pedram-rezaie/elizabeth-scope/hardware/bom/BOM.csv

Name | Description | Designator | Footprint | LibRef | Quantity | Value
Cap | Capacitor | C1, C3, C4, C6, C11, C12, C25, C26, C35, C38, C39, C40, C41, C42, C44, C45, C47, C49 | 0603 | Cap | 18 | 100nF
Cap | Capacitor | C2, C30, C33, C106, C107, C108 | 0603 | Cap | 6 | 10uF
Cap | Capacitor | C5 | 0603 | Cap | 1 | 200pF
Cap | Capacitor | C7 | 0603 | Cap | 1 | 560pF
Cap | Capacitor | C8 | 0603 | Cap | 1 | 3.3pF
Cap | Capacitor | C9 | 0603 | Cap | 1 | 2nF
Cap | Capacitor | C10 | 0603 | Cap | 1 | 750pF
Cap | Capacitor | C13, C43 | 0603 | Cap | 2 | 1uF
100uF | 100 µF, 50 V aluminum electrolytic capacitor, ±20%, SMD, 8 × 10.2 mm, 105°C | C15, C17 | CAP-SMD_BD8.0-L8.3-W8.3-FD | VT1H101M0810 | 2
Cap | Capacitor | C22, CP3, CP6, CP7 | 0805 | Cap | 4 | 100nF
Cap | Capacitor | C23, CP4, CP5, CP10 | 0805 | Cap | 4 | 10uF
Cap | Capacitor | C27, C28, C29, C31 | 0603 | Cap | 4 | 0.1uF
Cap | Capacitor | C32 | 0603 | Cap | 1 | 47pF
Cap | Capacitor | C36, C37 | 0603 | Cap | 2 | 22pF
Cap | Capacitor | C46, C48 | 0603 | Cap | 2 | 2,2uF
YLED0805YG | Dual Schottky diode, 70 V, 70 mA, SOT-23 package. | D1 | SOT-23-3 | BAS7004E6327HTSA1 | 1
GBLC08CI-LF-T7 | Bidirectional TVS/ESD protection diode, 8 V standoff, 13.4 V clamping, 0.6 pF capacitance | D2 | SOD-323_L1.8-W1.3-LS2.5-BI | GBLC08CI-LF-T7 | 1
YLED0805YG | LED GREEN CLEAR SMD | D3, D4 | FP-LTST-C171KGKT-MFG | CMP-22017-000037-1 | 2
nSMD050-33V | Resettable PTC fuse, 0.5 A hold current, 33 V max | F1, F2 | 1206 | nSMD050-33V | 2
A2541WV-2P | 2-pin male pin header, 2.54 mm pitch, single-row, straight through-hole, 3 A, 250 V. | H1 | HDR-TH_P2.54-H-M_A2541WV-2P | A2541WV-2P_C225477 | 1
B2B-XH-A(LF)(SN) | 2-pin JST XH series wire-to-board header, 2.5 mm pitch, straight through-hole, 3 A, 250 V | J1, J2 | B2B-XH-A(LF)(SN) | B2B-XH-A(LF)(SN) | 2
GCT_USB4930-00-A_REVA | Type C USB 2.0 Connector | J3 | GCT_USB4930-00-A_REVA | GCT_USB4930-00-A_REVA | 1
AO3401A | P-channel MOSFET, -30 V, -4 A, low RDS(on) | Q1 | SOT-23-3_L2.9-W1.6-P1.90-LS2.8-BR | AO3401A_C5379091 | 1
AO3400A | N-channel MOSFET, 30 V, 5.7 A, low RDS(on) | Q2 | SOT-23-3_L2.9-W1.3-P1.90-LS2.4-BR | AO3400A_C42419946 | 1
Res1 | Resistor | R1, R2, R3, R8, R46, R101, R102, R103 | 0603 | Res1 | 8 | 1k
Res1 | Resistor | R4 | 0603 | Res1 | 1 | 64.9
Res1 | Resistor | R5 | 0603 | Res1 | 1 | 237
Res1 | Resistor | R6 | 0603 | Res1 | 1 | 82.5
Res1 | Resistor | R7 | 0603 | Res1 | 1 | 178
Res1 | Resistor | R9, R26 | 0805 | Res1 | 2 | 100k
Res1 | Resistor | R10 | 0603 | Res1 | 1 | 100k
Res1 | Resistor | R11, R108 | 0603 | Res1 | 2 | 5.1K
Res1 | Resistor | R12 | 0603 | Res1 | 1 | 47k
Res1 | Resistor | R13 | 0603 | Res1 | 1 | 22k
Res1 | Resistor | R17, R18, R19, R20, R21, R22, R23, R24, R37, R105 | 0603 | Res1 | 10 | 47
Res1 | Resistor | R25 | 0603 | Res1 | 1 | 143
Res1 | Resistor | R27 | 0603 | Res1 | 1 | 100
Res1 | Resistor | R40, R41 | 0603 | Res1 | 2 | 10k
Res1 | Resistor | R45 | 0603 | Res1 | 1 | 22
Res1 | Resistor | R100 | 0603 | Res1 | 1 | 1M
3GHz | 50 O right-angle BNC PCB connector, through-hole, DC–3 GHz, 9.5 mm interface | RF1 | ANT-TH_KH-BNC50-3511 | KH-BNC50-3511 | 1
TS-1187A-B-A-B | SMD tactile pushbutton switch, SPST-NO, 12 V, 50 mA, 5.1 × 5.1 × 1.5 mm. | SW1, SW2 | SKQGABE010 | TS-1187A-B-A-B | 2
OPA356AIDBVT | High-speed CMOS single operational amplifier, 200 MHz GBW, rail-to-rail output | U1, U2, U3, U9 | SOT-23-5 | OPA356AIDBVT | 4
OPA1656IDR | Dual FET-input audio op-amp, 2.9nV/vHz, 53MHz GBW, SOIC-8 | U4 | SOIC-8 | OPA1656IDR | 1
USBLC6-2SC6_C5261088 |  | U5 | SOT-23-6_L2.9-W1.6-P0.95-LS2.8-BR | USBLC6-2SC6_C5261088 | 1
AP2112K-3.3TRG1(MS) | 3.3 V, 600 mA fixed-output LDO regulator with enable | U6, U7 | SOT-23-5_L2.9-W1.6-P0.95-LS2.7-BR | AP2112K-3.3TRG1(MS) | 2
ADG708CRUZ-REEL7 | 8:1 low-voltage analog multiplexer/switch, 4.5 O max RON, 55 MHz bandwidth | U8 | TSSOP-16 | ADG708CRUZ-REEL7 | 1
ADC1173CIMTCX/NOPB | 8-bit, 15 MSPS single-channel ADC, 3 V supply | U10 | TSSOP-24 | ADC1173CIMTCX/NOPB | 1
2541WV-05P | 5-pin single-row male pin header, 2.54 mm pitch, through-hole, straight. | U11 | HDR-TH_5P-P2.54-V-M | 2541WV-05P | 1
STM32F407VGT6 |  | U12 | LQFP-100_L14.0-W14.0-P0.50-LS16.0-BL | STM32F407VGT6 | 1
REF3030AIDBZR | 3.0 V precision voltage reference, ±0.2% accuracy, 25 mA output | U13 | SOT-23-3_L2.9-W1.6-P1.90-LS2.8-BR_2 | REF3030AIDBZR | 1
8MHz |  | X1 | CRYSTAL-SMD_4P-L3.2-W2.5-BL | 0132M4-8000F18DZNGL | 1
