pedram-rezaie/elizabeth-scope/hardware/docs/elizabeth.pdf

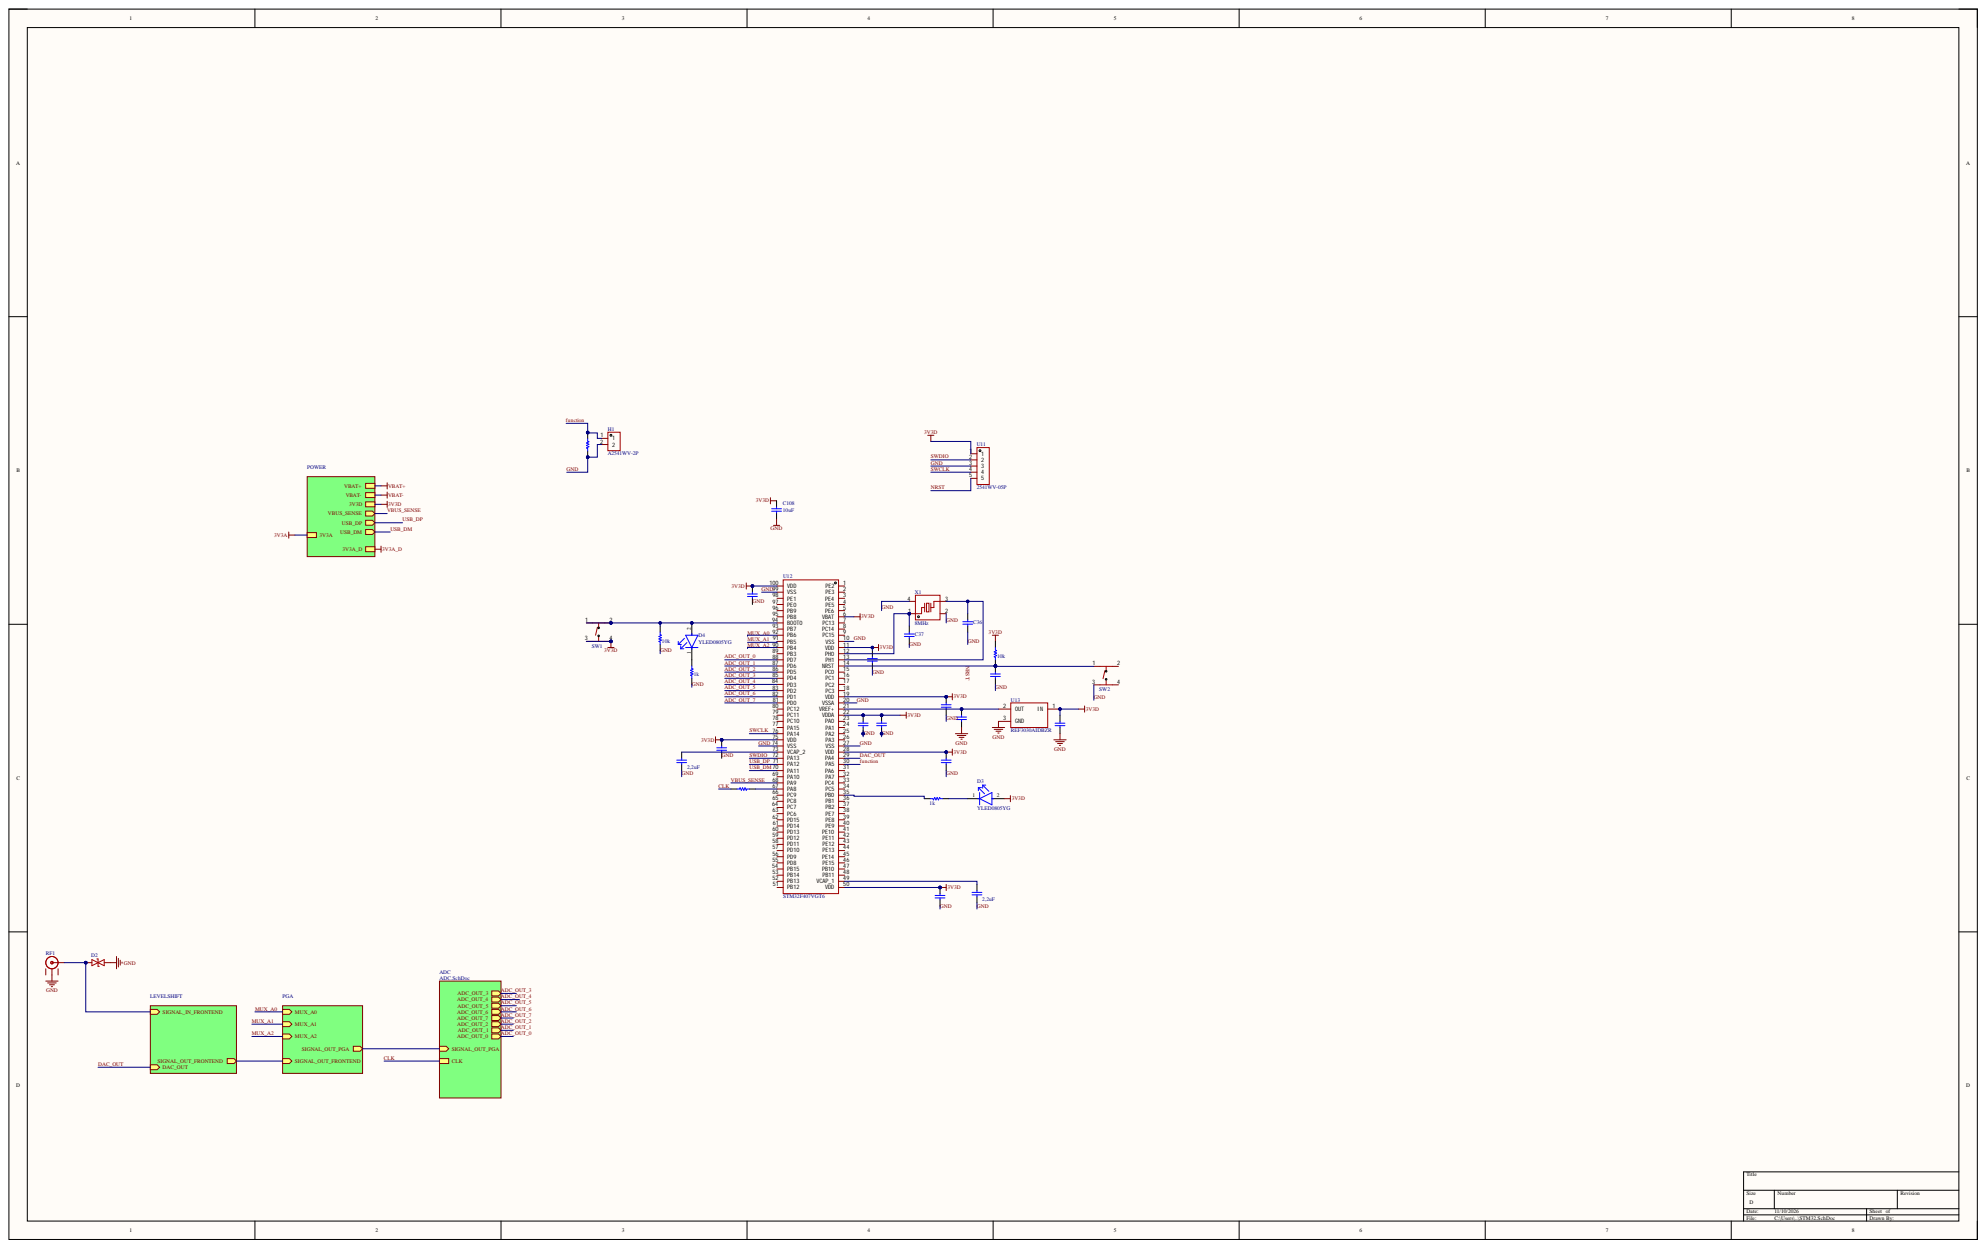
[picture p1: page 1]

Size D | Nu mber | Revision

Date: 11/10/2026 | Sheet of
File: C:\Users\. .\STM32.SchDoc | Drawn By:

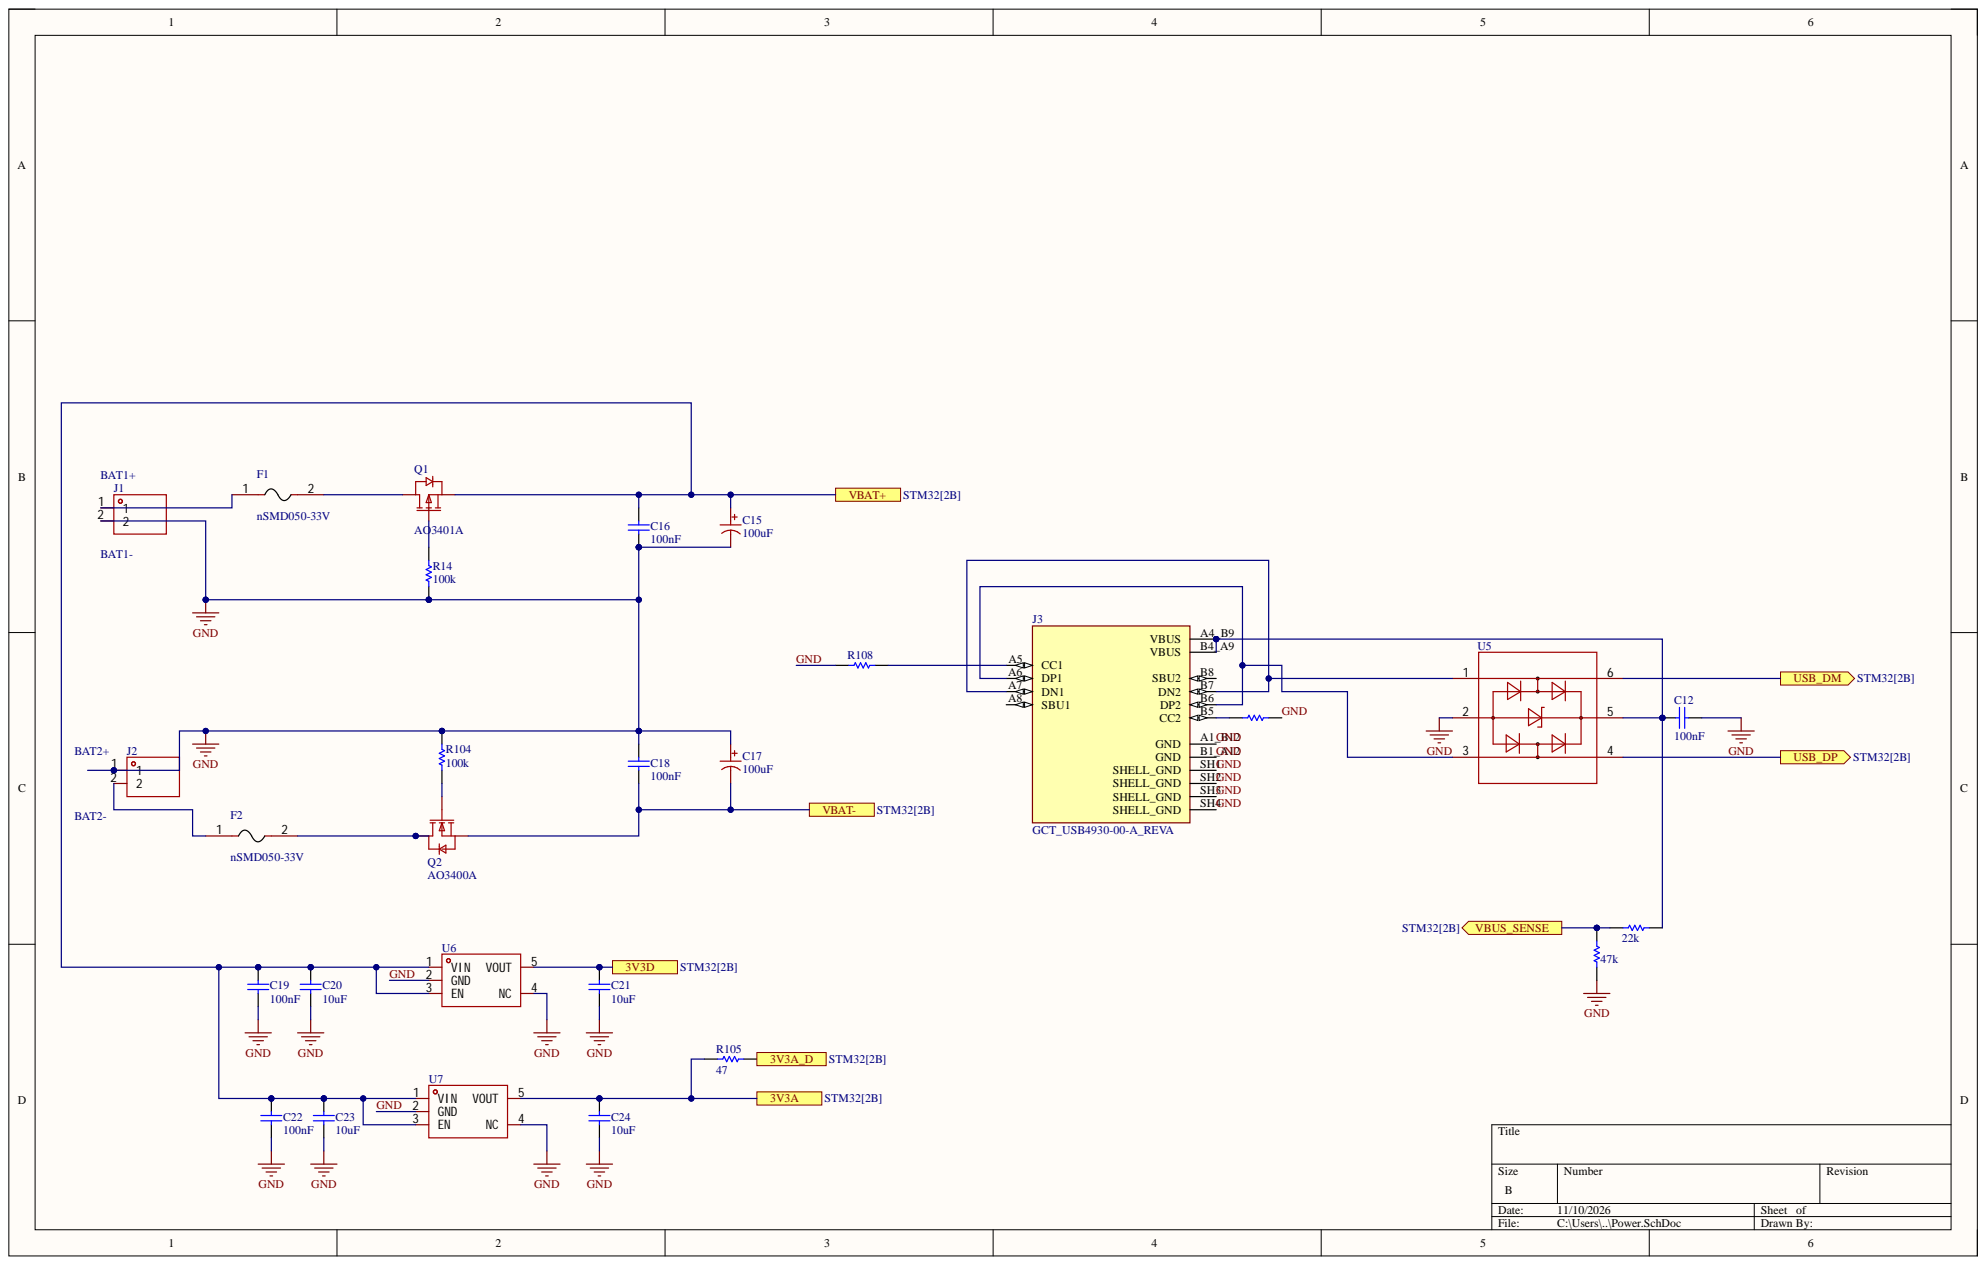
[picture p2: page 2]

Size B | Number | Revision

Date: 11/10/2026 | Sheet of
File: C:\Users\..\Power.SchDoc | Drawn By:

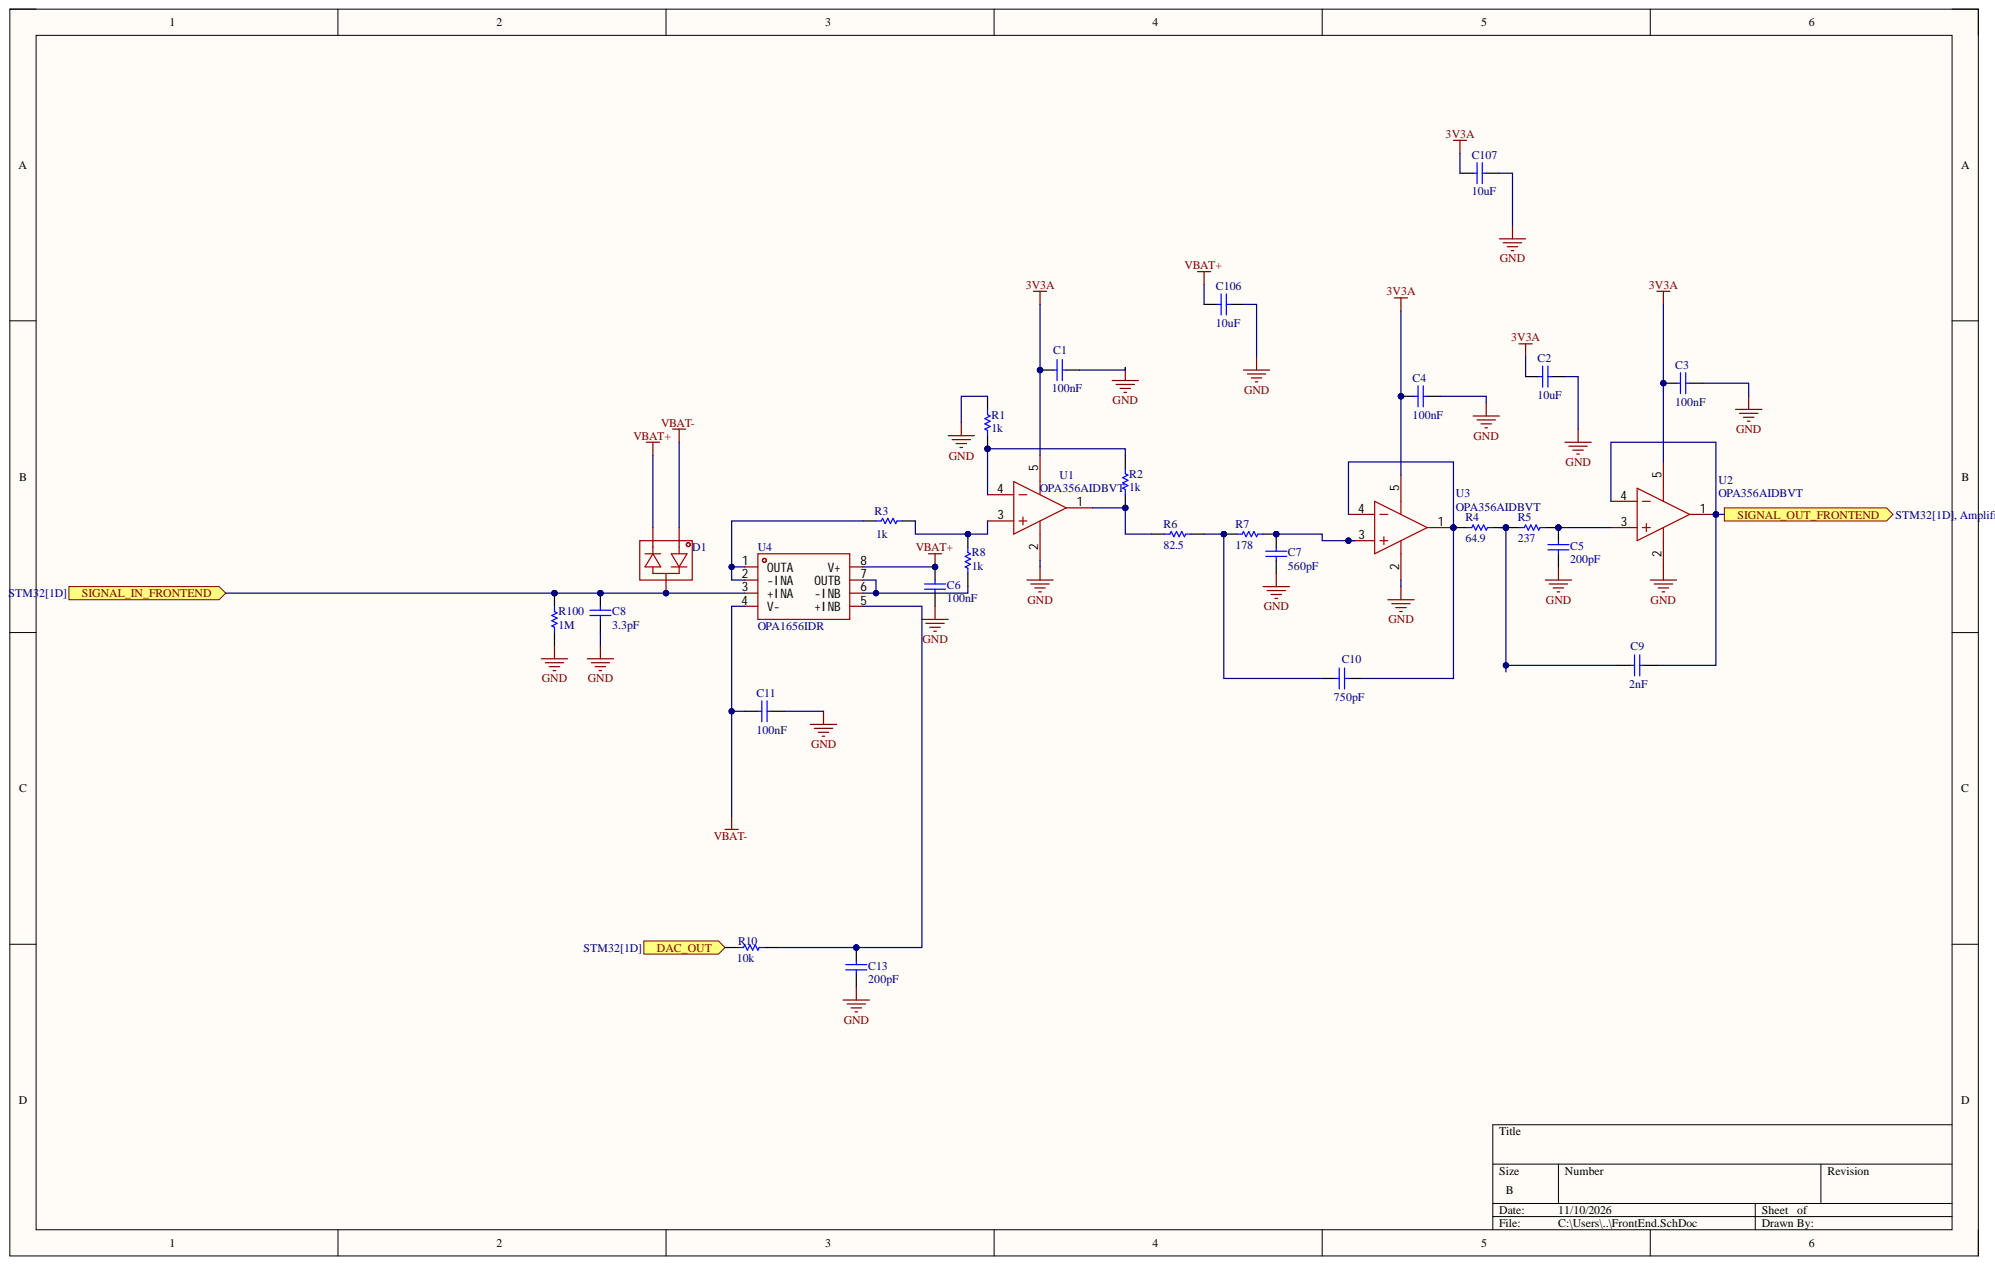
[picture p3: page 3]

Size B | Number | Revision

Date: 11/10/2026 | Sheet of
File: C:\Users\..\FrontEnd.SchDoc | Drawn By:

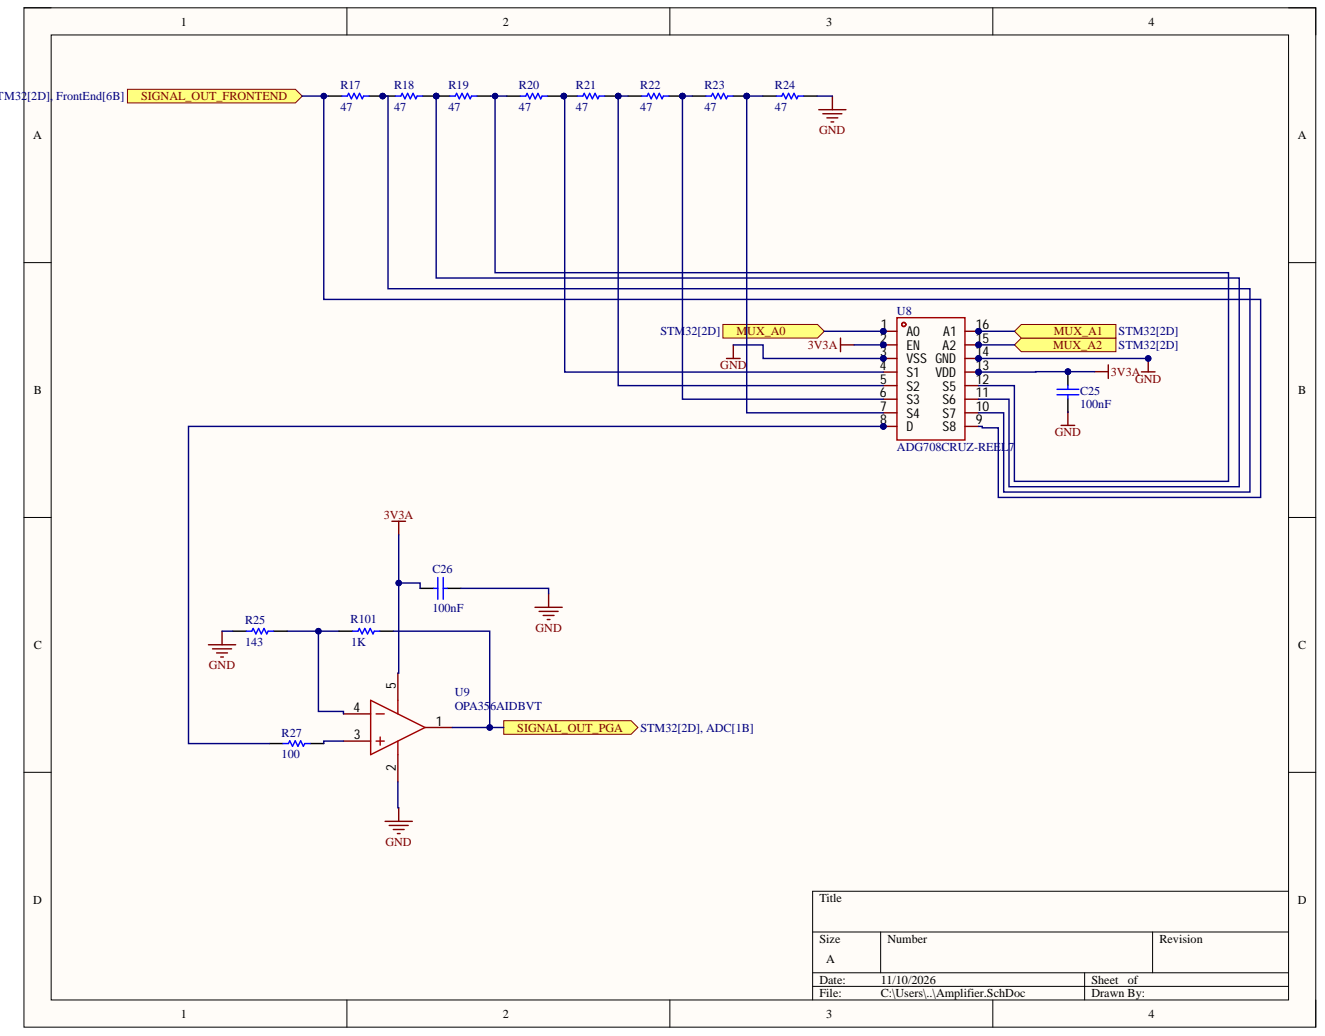
[picture p4: page 4]

S2 5
S3 6
S4 7

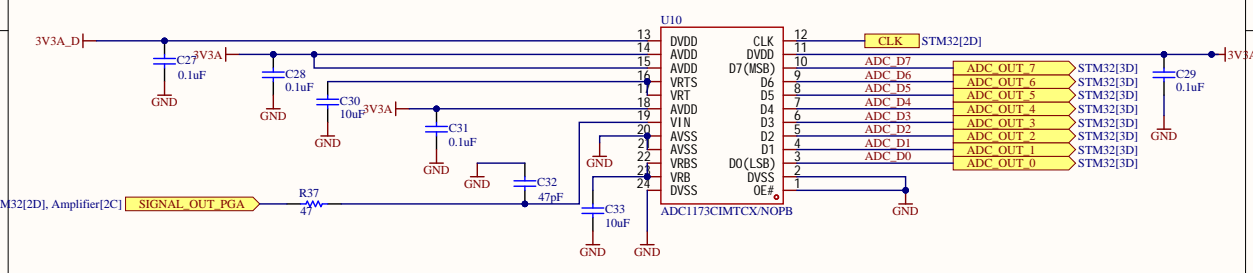
[picture p5: page 5]

VIN 19 | ADC_D3
AVSS 20

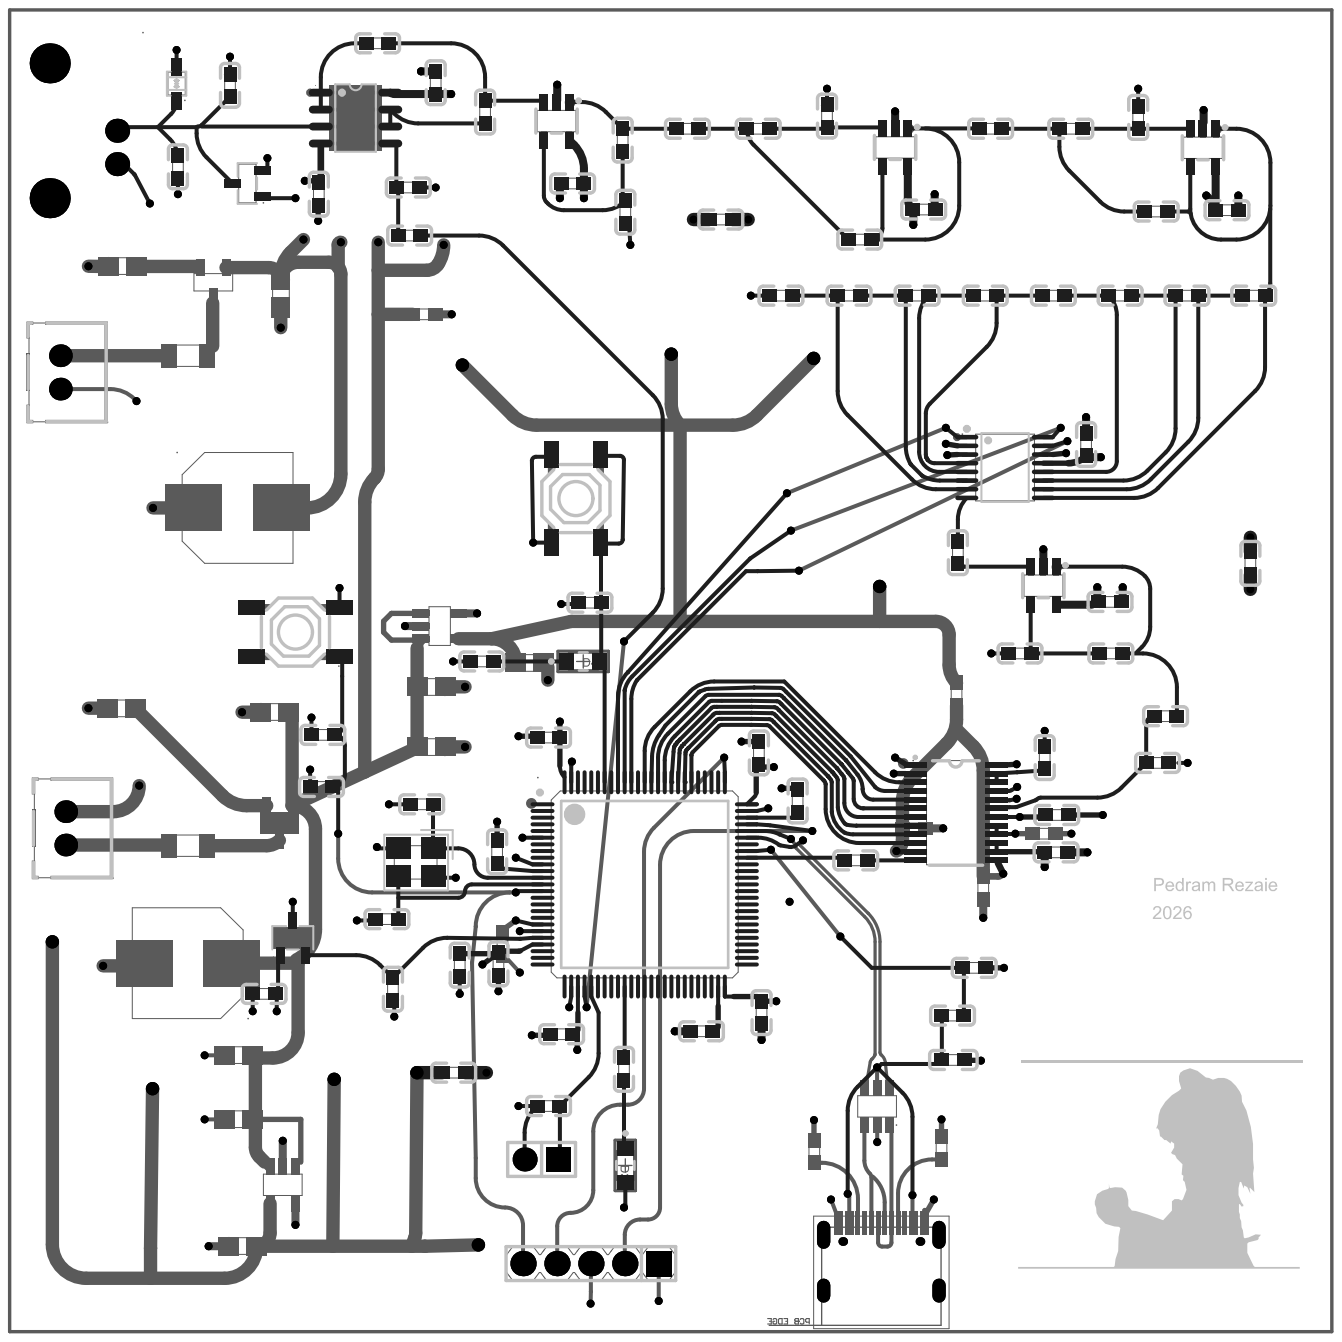
[picture p6: page 6]
