pedram-rezaie/elizabeth-scope/(list of files, drawings)

Other design files:
hardware/altium/ADC.SchDoc
hardware/altium/Amplifier.SchDoc
hardware/altium/DAC.SchDoc
hardware/altium/Elizabeth.PrjPcb
hardware/altium/FrontEnd.SchDoc
hardware/altium/PCB1.PcbDoc
hardware/altium/Power.SchDoc
hardware/altium/STM32.SchDoc
