pedram-rezaie/elizabeth-scope/(commit log)

2026-11-10 Firmware, hardware, software and docs
    [ADC.SchDoc, Amplifier.SchDoc, BOM.csv, DAC.SchDoc, Elizabeth.PrjPcb, FrontEnd.SchDoc, PCB1.PcbDoc, Power.SchDoc]
2026-11-11 Add Gerbers
